angtroake/MummerPlug/README.md

# MummerPlug
Open source smart plug solution. Still in development.
