angtroake/MummerPlug/(commit log)

2022-07-16 hardware init
    [MummerPlug.kicad_pcb, MummerPlug.kicad_sch]
2022-07-17 schematic esp and en
    [MummerPlug.kicad_sch]
2022-07-17 Cleaned up and add plug circuit
    [ESP.kicad_sch, MummerPlug.kicad_sch, Plugs.kicad_sch]
2022-07-17 assign footprint to esp symbol
    [ESP.kicad_sch, MummerPlug.kicad_sch, Plugs.kicad_sch]
2022-07-17 fix enable pin
    [ESP.kicad_sch]
2022-07-17 current sensor symbol
2022-07-17 current sensor footprint and insert into schematic
    [MummerPlug.kicad_sch, Plugs.kicad_sch]
